Smithsonian/TE-Development/DIY Arduino-based Redox Measurement System/Parts List/DIY Redox System Parts list.xlsx

COMPONENT Category | Item | Description | link (hyperlinked) | Source | Quantity | Price each | Total
DIY REDOX System:
POWER
 | 2.2uF capacitor | Elecrolytic Cap, TH | https://www.digikey.com/en/products/detail/w%C3%BCrth-elektronik/860020672006/5727089 | Digikey | 1 | 0.11 | 0.11
 | .33uF capacitor | Capacitor through-hole ceramic | https://www.digikey.com/en/products/detail/tdk-corporation/FA24X7R1H334KNU06/5866154 | Digikey | 2 | 0.257 | 0.514
 | .1uF capacitor | Capacitor through-hole ceramic | https://www.digikey.com/en/products/detail/vishay-beyschlag-draloric-bc-components/K104K15X7RF5TH5/286555 | Digikey | 2 | 0.161 | 0.322
 | 1uF capacitor | Elecrolytic Cap, TH | https://www.digikey.com/en/products/detail/w%C3%BCrth-elektronik/860020672005/5727088 | Digikey | 1 | 0.1 | 0.1
 | 1N5819 | Diode through-hole | https://www.digikey.com/en/products/detail/stmicroelectronics/1N5819/1037326 | Digikey | 1 | 0.288 | 0.288
 | LED 5mm through hole | LED | https://www.digikey.com/en/products/detail/marktech-optoelectronics/MT2118-G-A/4214619 | Digikey | 1 | 0.175 | 0.175
 | PDME2-S12-D9-S | DC-DC 12V --> +/-9V converter | https://www.digikey.com/en/products/detail/cui-inc/PDME2-S12-D9-S/15273178 | Digikey | 1 | 4.184 | 4.184
 | 1kohm resistor | Through-hole Resistor | https://www.digikey.com/en/products/detail/stackpole-electronics-inc/CF14JT1K00/1741314 | Digikey | 1 | 0.056 | 0.056
 | L7805 | Positive VOLTAGE REGULATOR +5V | https://www.digikey.com/en/products/detail/stmicroelectronics/L7805CV/585964 | Digikey | 2 | 0.605 | 1.21
 | L7905 | Negative VOLTAGE REGULATOR -5V | https://www.digikey.com/en/products/detail/stmicroelectronics/L7905ACV/585992 | Digikey | 1 | 0.812 | 0.812
 |  |  |  |  |  | TOTAL | 7.771
ANALOG IN
 | AD620 Instumentation Amplifier Module (breakout board) | Instrumentation Amplifier Module | https://protosupplies.com/product/ad620-instrumentation-amplifier-module/ | Proto Supplies | 1 | 5.95 | 5.95
 | 6 Pin Screw Terminal Block, 5mm pitch TH | 5mm Terminal Block | https://www.digikey.com/en/products/detail/phoenix-contact/1935200/568618 | Digikey | 1 | 1.506 | 1.506
 | 8 Pin Screw Terminal Block, 5mm pitch | 5mm Terminal Block | https://www.digikey.com/en/products/detail/phoenix-contact/1935226/568620 | Digikey | 2 | 1.966 | 3.932
 |  |  |  |  |  | TOTAL | 11.388
DIGITAL OUT
 | 1N5819 | Diode through-hole | https://www.digikey.com/en/products/detail/stmicroelectronics/1N5819/1037326 | Digikey | 1 | 0.288 | 0.288
 | 2 Pin Screw Terminal Block, 5mm pitch | 5mm Terminal Block | https://www.digikey.com/en/products/detail/phoenix-contact/1935161/568614 | Digikey | 1 | 0.533 | 0.533
 | 2x4 Dual Pin Header, 2.54mm pitch TH | 2.54mm dual pin header | https://www.digikey.com/en/products/detail/adam-tech/PH2-08-UA/9830443 | Digikey | 1 | 0.132 | 0.132
 | 4 Pin Screw Terminal Block, 5mm pitch | 5mm Terminal Block | https://www.digikey.com/en/products/detail/phoenix-contact/1935187/568616 | Digikey | 1 | 1.041 | 1.041
 | JST-PH 2mm | STEMMA I2C connector | https://www.digikey.com/en/products/detail/jst-sales-america-inc/B4B-PH-K/768444 | Digikey | 2 | 0.223 | 0.446
 | NZX5V1B | Zener Diode, Through-Hole | https://www.digikey.com/en/products/detail/nexperia-usa-inc/NZX5V1B-133/2119757 | Digikey | 1 | 0.166 | 0.166
 |  |  |  |  |  | TOTAL | 2.606
RELAY BOARD
 | G3VM-61A | Solid State Relay | https://www.mouser.com/ProductDetail/Omron-Electronics/G3VM-61A?qs=kyocjfxn8IqC2Wl8eZLLew%3D%3D | Mouser | 4 | 6.69 | 26.76
 | 460 ohms resistor | Through-hole Resistor |  |  | 4 | 0.025 | 0.1
 | 2 Pin Screw Terminal Block, 5mm pitch | 5mm Terminal Block | https://www.digikey.com/en/products/detail/phoenix-contact/1935161/568614 | Digikey | 3 | 0.288 | 0.864
 | 4 Pin Screw Terminal Block, 5mm pitch | 5mm Terminal Block | https://www.digikey.com/en/products/detail/phoenix-contact/1935187/568616 | Digikey | 2 | 0.132 | 0.264
 |  |  |  |  |  | TOTAL | 27.988
ARDUINO BOARD
 | Arduino Mega2560 | ARDUINO MEGA2560 ATMEGA2560 | https://www.digikey.com/en/products/detail/arduino/A000067/2639006 | Digikey | 1 | 41.14 | 41.14
 | Data Logging Shield | Data Logger Data Acquisition Arduino Platform | 1141 Adafruit Industries LLC | Development Boards, Kits, Programmers | DigiKey (https://www.digikey.com/en/products/detail/adafruit-industries-llc/1141/5011060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) | Digikey | 1 | 13.95 | 13.95
 | SD card |  |  | Amazon | 1 | 5.92 | 5.92
 |  |  |  |  |  | TOTAL | 61.01
LCD DISPLAY | I2C LCD | I2C LCD2004 | https://www.digikey.com/en/products/detail/sunfounder/CN0296D/18668625?gclsrc=aw.ds&utm_source | Digikey | 1 | 13.3 | 13.3
SOIL PROBES
 | Reference Probe |  |  | TE Lab | 1 | 245
 | Redox Probe |  |  | TE Lab |  | 130
