Smithsonian/TE-Development/DIY Arduino-based Redox Measurement System/PCB Design/Current Design V1.1/Redox1.1 Integration Trial.brd

## EAGLE design DIY Arduino-based Redox Measurement System/PCB Design/Current Design V1.1/Redox1.1 Integration Trial.brd (2024-12-04)

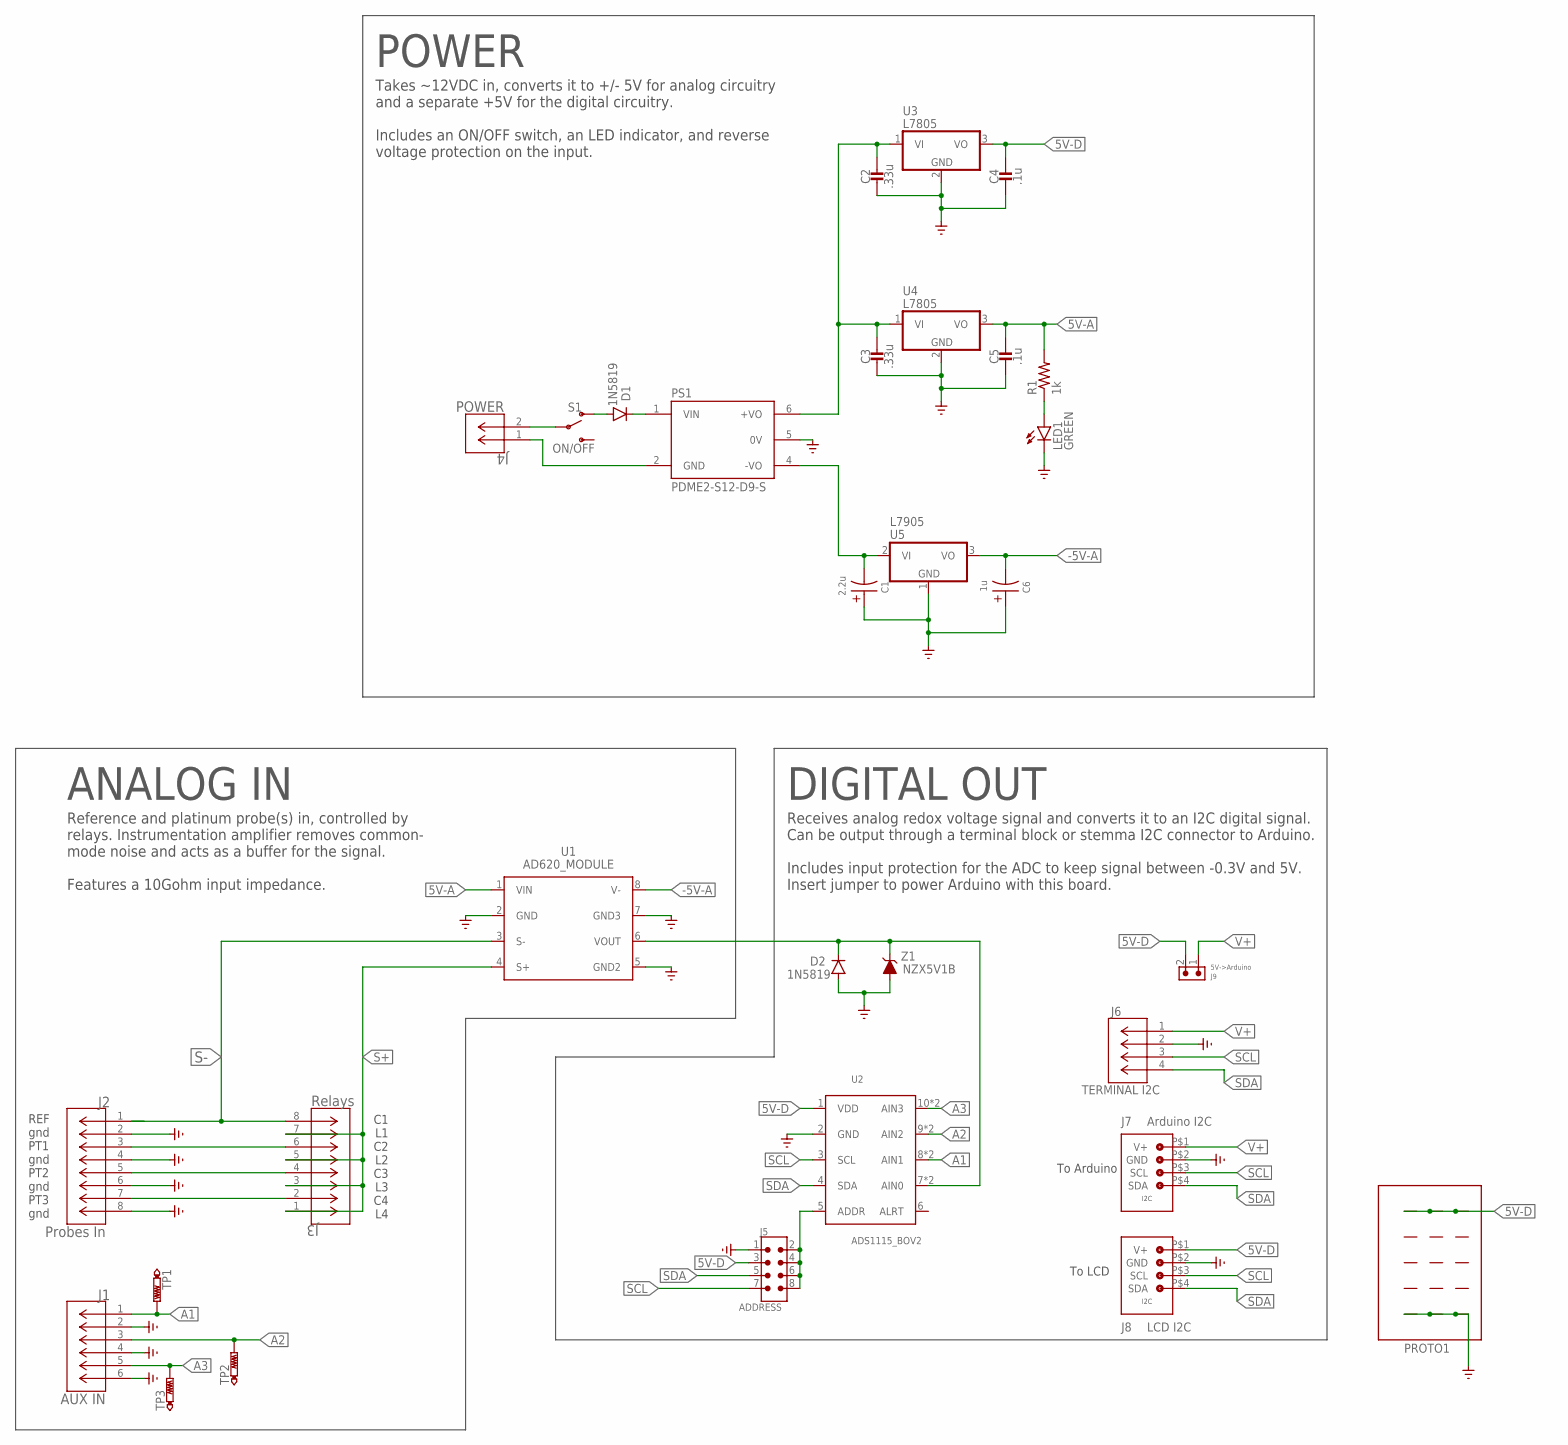
[picture p1: schematic Redox1.1 Integration Trial.sch]

Parts:
C1: 2.2u; E2,5-5
C2, C3: .33u; THCAPCERAMIC
C4, C5: .1u; THCAPCERAMIC
C6: 1u; E2,5-5
D1, D2: 1N5819; DIODE-TH
J1: AUX IN; 6PIN_TERMINAL_5MM
J2: Probes In; 8PIN_TERMINAL_5MM
J3: Relays; 8PIN_TERMINAL_5MM
J4: POWER; CONN2_710002_WRE
J5: ADDRESS; 61300821121
J6: TERMINAL I2C; 4PIN_TERMINAL_5MM
J7: Arduino I2C; JST_PH_4PIN
J8: LCD I2C; JST_PH_4PIN
J9: 5V->Arduino; 61300211121
LED1: GREEN; LED-5MM-TH
PROTO1: PROTO_AREA_5X3
PS1: PDME2-S12-D9-S; CONV_PDME2-S12-D9-S
R1: 1k; THRESISTOR
S1: ON/OFF; TT11_SPDT
TP1, TP2, TP3: PTR1PAD1-13; P1-13
U1: AD620_MODULE
U2: ADS1115_BOV2; ADS1115_V2
U3, U4: L7805; TO220V
U5: L7905; TO220V
Z1: NZX5V1B; DIODE-TH

Connections:
5V-A: C5.C1 (1), R1.R2 (2), U1.1 (VIN), U4.3 (VO)
5V-D: C4.C1 (1), J5.3, J8.P$1 (V+), J9.2, PROTO1.1, PROTO1.2, PROTO1.3, U2.1 (VDD), U3.3 (VO)
-5V-A: C6.-, U1.8 (V-), U5.3 (VO)
A1: J1.1, TP1.TP, U2.8 (AIN1), U2.A1 (AIN1)
A2: J1.3, TP2.TP, U2.9 (AIN2), U2.A2 (AIN2)
A3: J1.5, TP3.TP, U2.10 (AIN3), U2.A3 (AIN3)
GND: C1.+, C2.C2 (2), C3.C2 (2), C4.C2 (2), C5.C2 (2), C6.+, D2.P$1 (A), J1.2, J1.4, J1.6, J2.2, J2.4, J2.6, J2.8, J5.1, J6.2, J7.P$2 (GND), J8.P$2 (GND), LED1.K (C), PROTO1.13, PROTO1.14, PROTO1.15, PS1.5 (0V), U1.2 (GND), U1.5 (GND2), U1.7 (GND3), U2.2 (GND), U3.2 (GND), U4.2 (GND), U5.1 (GND), Z1.P$1 (A)
unnamed: D2.P$2 (C), U1.6 (VOUT), U2.7 (AIN0), U2.A0 (AIN0), Z1.P$2 (C)
unnamed: C1.-, PS1.4 (-VO), U5.2 (VI)
unnamed: D1.P$2 (C), PS1.1 (VIN)
unnamed: J4.1, PS1.2 (GND)
unnamed: C2.C1 (1), C3.C1 (1), PS1.6 (+VO), U3.1 (VI), U4.1 (VI)
unnamed: J4.2, S1.P$2 (C)
unnamed: LED1.A, R1.R1 (1)
unnamed: D1.P$1 (A), S1.P$1 (1)
unnamed: J2.3, J3.6
unnamed: J2.5, J3.4
unnamed: J5.2, J5.4, J5.6, J5.8, U2.5 (ADDR)
unnamed: J2.7, J3.2
S+: J3.1, J3.3, J3.5, J3.7, U1.4 (S+)
S-: J2.1, J3.8, U1.3 (S-)
SCL: J5.7, J6.3, J7.P$3 (SCL), J8.P$3 (SCL), U2.3 (SCL)
SDA: J5.5, J6.4, J7.P$4 (SDA), J8.P$4 (SDA), U2.4 (SDA)
V+: J6.1, J7.P$1 (V+), J9.1

Notes on the sheet:
POWER
ANALOG IN
DIGITAL OUT
Takes ~12VDC in, converts it to +/- 5V for analog circuitry and a separate +5V for the digital circuitry. Includes an ON/OFF switch, an LED indicator, and reverse voltage protection on the input.
Receives analog redox voltage signal and converts it to an I2C digital signal. Can be output through a terminal block or stemma I2C connector to Arduino. Includes input protection for the ADC to keep signal between -0.3V and 5V. Insert jumper to power Arduino with this board.
Reference and platinum probe(s) in, controlled by relays. Instrumentation amplifier removes common- mode noise and acts as a buffer for the signal. Features a 10Gohm input impedance.
REF gnd PT1 gnd PT2 gnd PT3 gnd
C1 L1 C2 L2 C3 L3 C4 L4
To Arduino
To LCD

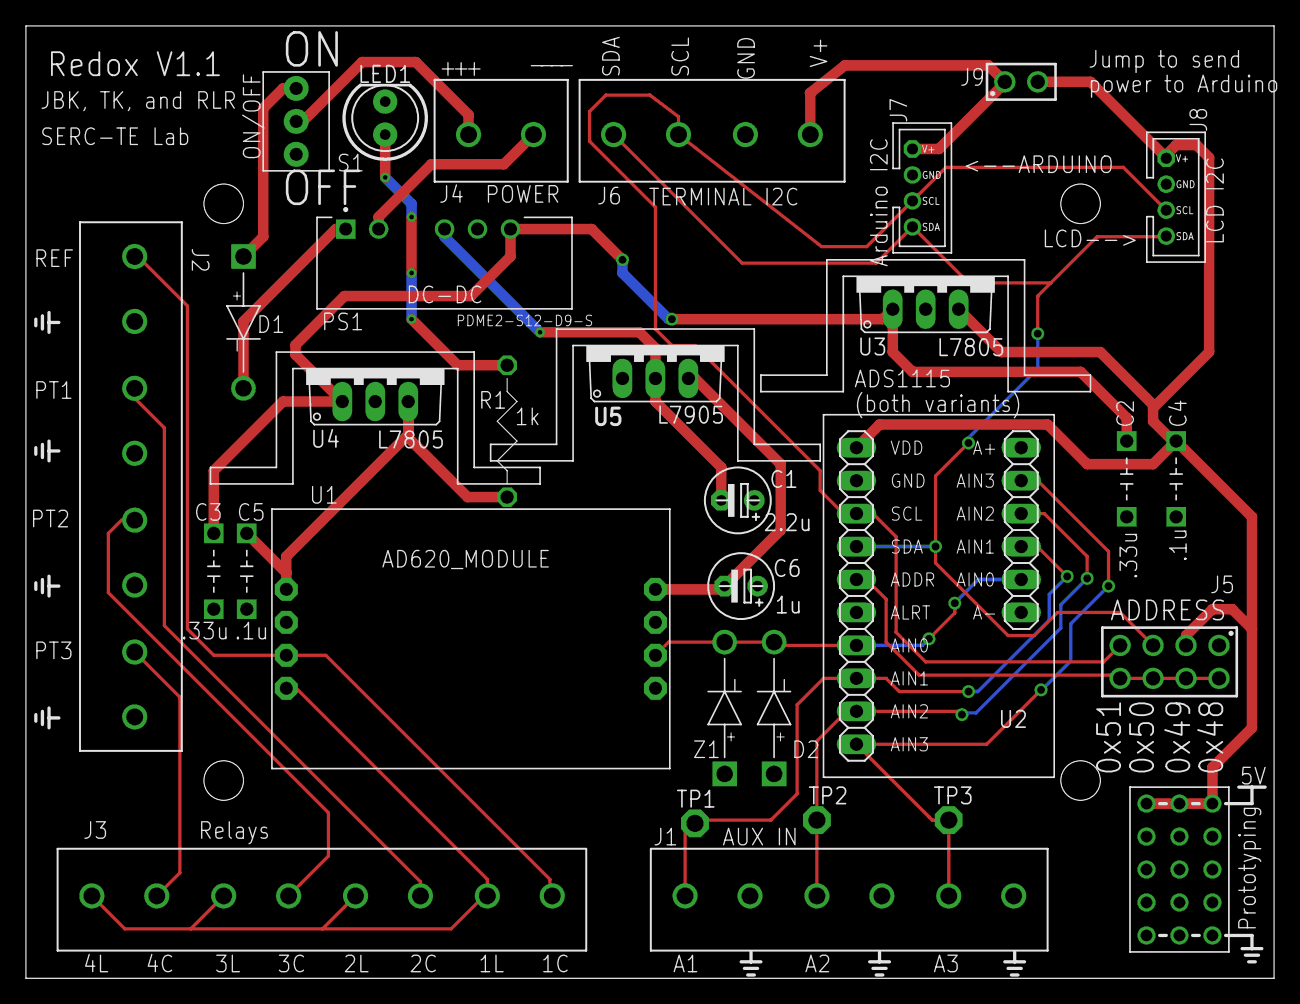
[picture p2: board Redox1.1 Integration Trial.brd from above]

Board: 2 copper layers, 96.2 x 73.4 mm, 31 parts (0 on the bottom side), 24 nets.
