Smithsonian/TE-Development/DIY Arduino-based Redox Measurement System/R Scripts/genx_redox_check.Rmd

---

title: "GENX REDOX"
author: "Presented by the TE Technicians"
date: "`r Sys.Date()`"
output: html_document
---

<style>
.vscroll-plot {
    width: 1000px;
    height: 600px;
    overflow-y: scroll;
    overflow-x: hidden;
}
</style>

#####  Please send suggestions to westbrooke@si.edu

``` {r load libraries and functions, include = F}

# Load libraries
library(knitr)
library(tidyverse)
library(data.table)
library(lubridate)
library(utils)
library(ggpubr)
library(gghighlight)
library(kableExtra)
library(pacman)
library(ggrepel)

#load in the usable functions for GENX
source(paste0(Sys.getenv("repository_filepath"),"/GENX/daily Rmd check scripts/genx_checks_functions.R"))

```

``` {r set knitr options,include = F}
options(width = 90)
local({
  hook_output <- knitr::knit_hooks$get('output')
  knitr::knit_hooks$set(output = function(x, options) {
    if (!is.null(options$max.height)) options$attr.output <- c(
      options$attr.output,
      sprintf('style="max-height: %s;"', options$max.height)
    )
    hook_output(x, options)
  })
})
```

``` {r load redox data, echo = F}
#the directory to the GENX current data and the patern for teh log files
data_dir <- paste0(Sys.getenv("TE_dropbox_filepath"),"/GCREW_LOGGERNET_DATA/current_data/")
pattern <- "GENX_Redox"

#Load the raw data log file. 
raw_data <- load_data(data_dir, pattern=pattern)

# Format timestamp
raw_data$TIMESTAMP <- as.POSIXct(raw_data$TIMESTAMP, format = "%Y-%m-%d %H:%M:%S")

# Filter data to be last 2 days. 
three_days_ago <- format(Sys.Date()-1,"%Y/%m/%d %H:%M:%S")
raw_data <- raw_data %>% filter(TIMESTAMP > three_days_ago)

#Rename the 10cm variables 
raw_data <- raw_data %>%
  rename("Ch01_10cm_P45_ref1_trA_B" = "Volt_Ref1(1)",
           "Ch01_10cm_P46_ref1_trA_B"= "Volt_Ref1(3)",
           "Ch04_10cm_P17_ref1_trA_G"= "Volt_Ref1(5)",
           "Ch04_10cm_P19_ref1_trA_G"= "Volt_Ref1(7)",
           "Ch07_10cm_P00_ref1_trA_Y"= "Volt_Ref1(9)",
           "Ch07_10cm_P01_ref1_trA_Y"= "Volt_Ref1(11)",
           "Ch10_10cm_P22_ref1_trA_R"= "Volt_Ref1(13)",
           "Ch10_10cm_P23_ref1_trA_R"= "Volt_Ref1(15)",
           "Ch03_10cm_P54_ref1_trB_B"= "Volt_Ref1(17)",
           "Ch03_10cm_P47_ref1_trB_B"= "Volt_Ref1(19)",
           "Ch06_10cm_P56_ref1_trB_G"= "Volt_Ref1(21)",
           "Ch06_10cm_P57_ref1_trB_G"= "Volt_Ref1(23)",
           "Ch09_10cm_P49_ref1_trB_Y"= "Volt_Ref1(25)",
           "Ch09_10cm_P48_ref1_trB_Y"= "Volt_Ref1(27)",
           "Ch12_10cm_P26_ref1_trB_R"= "Volt_Ref1(29)",
           "Ch12_10cm_P34_ref1_trB_R"= "Volt_Ref1(31)",
           "Ch02_10cm_P16_ref1_trC_B"= "Volt_Ref1(33)",
           "Ch02_10cm_P59_ref1_trC_B"= "Volt_Ref1(35)",
           "Ch05_10cm_P58_ref1_trC_G"= "Volt_Ref1(37)",
           "Ch05_10cm_P43_ref1_trC_G"= "Volt_Ref1(39)",
           "Ch08_10cm_P18_ref1_trC_Y"= "Volt_Ref1(41)",
           "Ch08_10cm_P40_ref1_trC_Y"= "Volt_Ref1(43)",
           "Ch11_10cm_P51_ref1_trC_R"= "Volt_Ref1(45)",
           "Ch11_10cm_P50_ref1_trC_R"= "Volt_Ref1(47)")

#Rename the 10cm variables ref2
raw_data <- raw_data %>%
  rename("Ch01_10cm_P45_ref2_trA_B" = "Volt_Ref2(1)",
           "Ch01_10cm_P46_ref2_trA_B"= "Volt_Ref2(3)",
           "Ch04_10cm_P17_ref2_trA_G"= "Volt_Ref2(5)",
           "Ch04_10cm_P19_ref2_trA_G"= "Volt_Ref2(7)",
           "Ch07_10cm_P00_ref2_trA_Y"= "Volt_Ref2(9)",
           "Ch07_10cm_P01_ref2_trA_Y"= "Volt_Ref2(11)",
           "Ch10_10cm_P22_ref2_trA_R"= "Volt_Ref2(13)",
           "Ch10_10cm_P23_ref2_trA_R"= "Volt_Ref2(15)",
           "Ch03_10cm_P54_ref2_trB_B"= "Volt_Ref2(17)",
           "Ch03_10cm_P47_ref2_trB_B"= "Volt_Ref2(19)",
           "Ch06_10cm_P56_ref2_trB_G"= "Volt_Ref2(21)",
           "Ch06_10cm_P57_ref2_trB_G"= "Volt_Ref2(23)",
           "Ch09_10cm_P49_ref2_trB_Y"= "Volt_Ref2(25)",
           "Ch09_10cm_P48_ref2_trB_Y"= "Volt_Ref2(27)",
           "Ch12_10cm_P26_ref2_trB_R"= "Volt_Ref2(29)",
           "Ch12_10cm_P34_ref2_trB_R"= "Volt_Ref2(31)",
           "Ch02_10cm_P16_ref2_trC_B"= "Volt_Ref2(33)",
           "Ch02_10cm_P59_ref2_trC_B"= "Volt_Ref2(35)",
           "Ch05_10cm_P58_ref2_trC_G"= "Volt_Ref2(37)",
           "Ch05_10cm_P43_ref2_trC_G"= "Volt_Ref2(39)",
           "Ch08_10cm_P18_ref2_trC_Y"= "Volt_Ref2(41)",
           "Ch08_10cm_P40_ref2_trC_Y"= "Volt_Ref2(43)",
           "Ch11_10cm_P51_ref2_trC_R"= "Volt_Ref2(45)",
           "Ch11_10cm_P50_ref2_trC_R"= "Volt_Ref2(47)")

#Rename the 25cm variables 
raw_data <- raw_data %>%
  rename("Ch01_25cm_P45_ref1_trA_B"= "Volt_Ref1(2)",
           "Ch01_25cm_P46_ref1_trA_B"= "Volt_Ref1(4)",
           "Ch04_25cm_P17_ref1_trA_G"= "Volt_Ref1(6)",
           "Ch04_25cm_P19_ref1_trA_G"= "Volt_Ref1(8)",
           "Ch07_25cm_P00_ref1_trA_Y"= "Volt_Ref1(10)",
           "Ch07_25cm_P01_ref1_trA_Y"= "Volt_Ref1(12)",
           "Ch10_25cm_P22_ref1_trA_R"= "Volt_Ref1(14)",
           "Ch10_25cm_P23_ref1_trA_R"= "Volt_Ref1(16)",
           "Ch03_25cm_P54_ref1_trB_B"= "Volt_Ref1(18)",
           "Ch03_25cm_P47_ref1_trB_B"= "Volt_Ref1(20)",
           "Ch06_25cm_P56_ref1_trB_G"= "Volt_Ref1(22)",
           "Ch06_25cm_P57_ref1_trB_G"= "Volt_Ref1(24)",
           "Ch09_25cm_P49_ref1_trB_Y"= "Volt_Ref1(26)",
           "Ch09_25cm_P48_ref1_trB_Y"=  "Volt_Ref1(28)",
           "Ch12_25cm_P26_ref1_trB_R"= "Volt_Ref1(30)",
           "Ch12_25cm_P34_ref1_trB_R"= "Volt_Ref1(32)",
           "Ch02_25cm_P16_ref1_trC_B"= "Volt_Ref1(34)",
           "Ch02_25cm_P59_ref1_trC_B"= "Volt_Ref1(36)",
           "Ch05_25cm_P58_ref1_trC_G"= "Volt_Ref1(38)",
           "Ch05_25cm_P43_ref1_trC_G"= "Volt_Ref1(40)",
           "Ch08_25cm_P18_ref1_trC_Y"= "Volt_Ref1(42)",
           "Ch08_25cm_P40_ref1_trC_Y"= "Volt_Ref1(44)",
           "Ch11_25cm_P51_ref1_trC_R"= "Volt_Ref1(46)",
           "Ch11_25cm_P50_ref1_trC_R"= "Volt_Ref1(48)")

#Rename the 25cm variables 
raw_data <- raw_data %>%
  rename("Ch01_25cm_P45_ref2_trA_B"= "Volt_Ref2(2)",
           "Ch01_25cm_P46_ref2_trA_B"= "Volt_Ref2(4)",
           "Ch04_25cm_P17_ref2_trA_G"= "Volt_Ref2(6)",
           "Ch04_25cm_P19_ref2_trA_G"= "Volt_Ref2(8)",
           "Ch07_25cm_P00_ref2_trA_Y"= "Volt_Ref2(10)",
           "Ch07_25cm_P01_ref2_trA_Y"= "Volt_Ref2(12)",
           "Ch10_25cm_P22_ref2_trA_R"= "Volt_Ref2(14)",
           "Ch10_25cm_P23_ref2_trA_R"= "Volt_Ref2(16)",
           "Ch03_25cm_P54_ref2_trB_B"= "Volt_Ref2(18)",
           "Ch03_25cm_P47_ref2_trB_B"= "Volt_Ref2(20)",
           "Ch06_25cm_P56_ref2_trB_G"= "Volt_Ref2(22)",
           "Ch06_25cm_P57_ref2_trB_G"= "Volt_Ref2(24)",
           "Ch09_25cm_P49_ref2_trB_Y"= "Volt_Ref2(26)",
           "Ch09_25cm_P48_ref2_trB_Y"=  "Volt_Ref2(28)",
           "Ch12_25cm_P26_ref2_trB_R"= "Volt_Ref2(30)",
           "Ch12_25cm_P34_ref2_trB_R"= "Volt_Ref2(32)",
           "Ch02_25cm_P16_ref2_trC_B"= "Volt_Ref2(34)",
           "Ch02_25cm_P59_ref2_trC_B"= "Volt_Ref2(36)",
           "Ch05_25cm_P58_ref2_trC_G"= "Volt_Ref2(38)",
           "Ch05_25cm_P43_ref2_trC_G"= "Volt_Ref2(40)",
           "Ch08_25cm_P18_ref2_trC_Y"= "Volt_Ref2(42)",
           "Ch08_25cm_P40_ref2_trC_Y"= "Volt_Ref2(44)",
           "Ch11_25cm_P51_ref2_trC_R"= "Volt_Ref2(46)",
           "Ch11_25cm_P50_ref2_trC_R"= "Volt_Ref2(48)")

raw_data_long <- pivot_longer(raw_data,cols = (4:ncol(raw_data)),names_to = "parameter", values_to = "value")

raw_data_long$chamber <- substr(raw_data_long$parameter,1,4)

raw_data_long$reference <- substr(raw_data_long$parameter,15,18)

raw_data_long$depth <- substr(raw_data_long$parameter,6,9)

raw_data_long$probe <- substr(raw_data_long$parameter,11,13)

raw_data_long$transect <- substr(raw_data_long$parameter,20,22)

raw_data_long$color <- substr(raw_data_long$parameter,24,24)

```

## GENX Zone Layout 
Below is a map of the heating for GENX. Zones 0 and 1 are ambient, and each zone after 1 increases temperature by 0.75C. Each of the three transects are heated separately. 
</br>
```{r zone image, echo =F}
knitr::include_graphics(paste0(Sys.getenv("TE_dropbox_filepath"),"/GenX/Photos/zone_image.png"))
```
</br>

 ## Redox Readings by Chamber 

```{r redox plot Grid, echo = F, warning = F} 

#Assigning transects to each logger
#raw_data_long %>%
 # ggplot(aes(x = TIMESTAMP, y = value, colour = reference)) + 
#  geom_line(na.rm = TRUE) +
#  facet_grid(transect ~ color) +
#  labs(y = "Voltage", x = "Date") +
#  scale_color_manual(values = c("blue", "red")) + 
#  theme_light()+
#  theme(
#    axis.text.x = element_text(angle = 45, hjust = 1),
#    legend.position = "none"
#  )

```

<div class="vscroll-plot">

```{r redox plots by chamber, echo = F}

chambers <- unique(raw_data_long$chamber)

for (current_chamber in chambers){
  
  print(current_chamber)
  
  chamber_data <- raw_data_long %>% 
    filter(chamber == current_chamber)
  
  plot <- chamber_data %>% 
    ggplot(aes(x = TIMESTAMP, y = as.numeric(value), colour = depth)) +
    geom_line()+
    ylim(-400,-300)+
    ggtitle(paste0("Redox Readings from Chamber ", substr(current_chamber,3,4)))+
    geom_label_repel(data = chamber_data %>% group_by(parameter) %>% slice_tail(n = 1), 
                   aes(x = TIMESTAMP, y = as.numeric(value), label = probe), 
                   size = 4, 
                   segment.color = "grey50",
                   show.legend = FALSE) + 
    theme(legend.title=element_blank()) +  labs(x = "Timestamp", y = "Voltage")+
            theme_light()+
            theme(axis.title.x = element_text(size = 16, face = "bold"),
            axis.title.y = element_text(size=16, face = "bold"))+
            theme(axis.text.x = element_text(size=14, face = "bold"),
            axis.text.y = element_text(size=14, face = "bold"))+
            theme(legend.title=element_blank())
  
  print(plot)
  
} 

```
