Smithsonian/TE-Development/DIY Arduino-based Redox Measurement System/Arduino Code/Redoxtest01292025/Calculations.ino

//*** take_measurement() function outputs ADC reading in volts ***//
// Function to take a redox potential measurement
//Reference Probes- relay 1
float zero(){
  int16_t in;
  float inVolts;
  digitalWrite(relay1, HIGH); //Connect probe to instrumentation amplifier [changed the polarity for SSR (changed by TH)]
  delay(10); //Give probe a (hundredth of a) second--maybe unnecessary?
  in = ads.readADC_SingleEnded(redoxChannel); //Take reading with ADC
  inVolts = ads.computeVolts(in); //Convert to volts
  digitalWrite(relay1, LOW); //Disconnect probe from amplifier [changed the polarity for SSR (changed by TH)]
  return inVolts;
}


// Calibration function to determine the amplifier offset with referrence to PT1
float take_measurementPT1(){
  int16_t in;
  float inVolts;
  digitalWrite(relay2, HIGH); // Close relay2, short inputs to the amplifier [changed the polarity for SSR (changed by TH)]
  delay(100); // I think there should be a delay after relay closes
  in = ads.readADC_SingleEnded(redoxChannel);
  inVolts = ads.computeVolts(in);
  digitalWrite(relay2, LOW); // [changed the polarity for SSR (changed by TH)]
  return inVolts;
}

// Calibration function to determine the amplifier offset with referrence to PT2
float take_measurementPT2(){
  int16_t in;
  float inVolts;
  digitalWrite(relay3, HIGH); // Close relay2, short inputs to the amplifier [changed the polarity for SSR (changed by TH)]
  delay(100); // I think there should be a delay after relay closes
  in = ads.readADC_SingleEnded(redoxChannel);
  inVolts = ads.computeVolts(in);
  digitalWrite(relay3, LOW); // [changed the polarity for SSR (changed by TH)]
  return inVolts;
}

// Calibration function to determine the amplifier offset with referrence to PT3
float take_measurementPT3(){
  int16_t in;
  float inVolts;
  digitalWrite(relay4, HIGH); // Close relay2, short inputs to the amplifier [changed the polarity for SSR (changed by TH)]
  delay(100); // I think there should be a delay after relay closes
  in = ads.readADC_SingleEnded(redoxChannel);
  inVolts = ads.computeVolts(in);
  digitalWrite(relay4, LOW); // [changed the polarity for SSR (changed by TH)]
  return inVolts;
}
