Smithsonian/TE-Development/(commit log)

2024-12-04 Create DIY Arduino-based Redox Measurement System
2024-12-04 Create PCB Design
    The Printed Circuit Board (PCB) Schematic Design and Layout
