Smithsonian/TE-Development/(notices)

Notices in the files:
parts and their libraries:
Wurth_Connectors_WR-PHD: Copyright: Würth Elektronik
COPYRIGHT: Copyright (C) 2023 Ultra Librarian. All rights reserved.
COPYRIGHT: Copyright (C) 2024 Ultra Librarian. All rights reserved.
